topherCantrell/iot-DeskController/art/elevate.docx

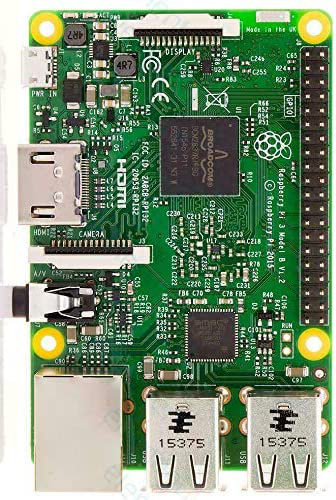
[picture p11: figure]
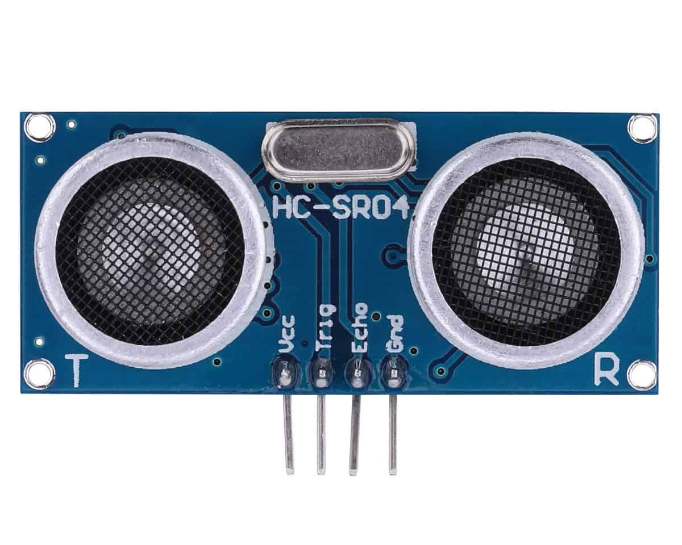
[picture p12: figure]
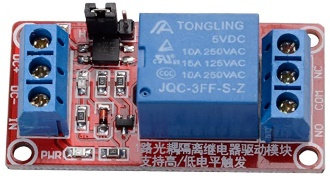
[picture p13: figure]

Common

Up

Down

COM

COM

NO

NO

5V

Gnd

Gnd

GP23

GP24

GP5

GP6

1K

2K
