topherCantrell/iot-DeskController/art/complete.jpg

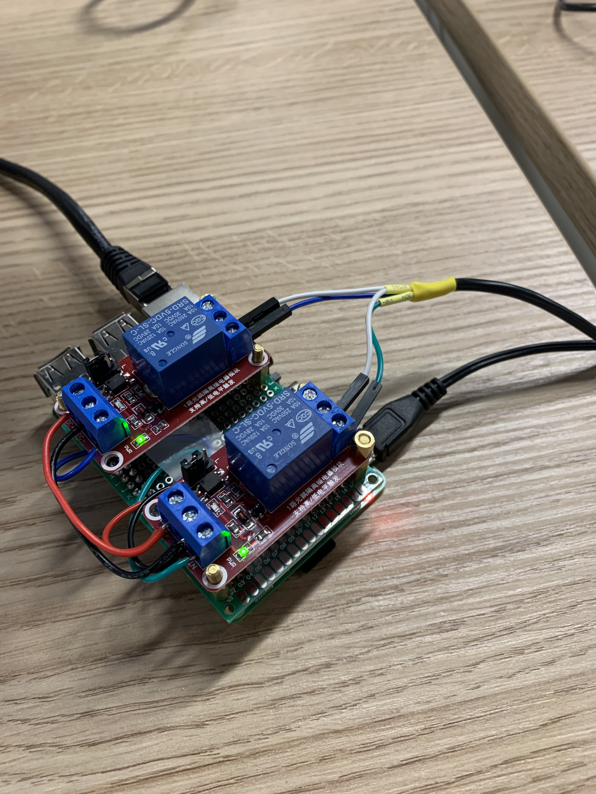
art/complete.jpg
