topherCantrell/iot-DeskController/art/desk01.jpg

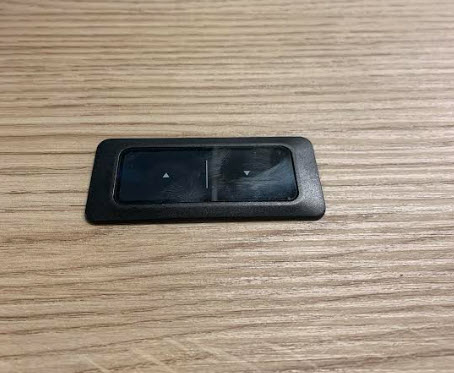
art/desk01.jpg
