topherCantrell/iot-DeskController/art/desk02.jpg

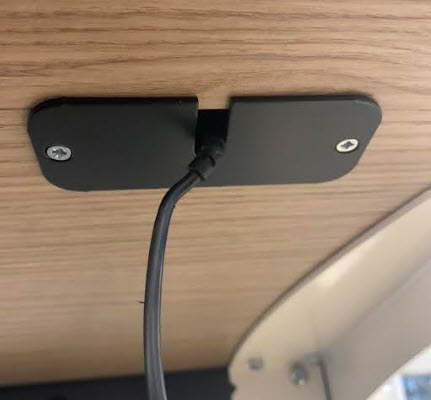
art/desk02.jpg
