topherCantrell/iot-DeskController/art/piboard.jpg

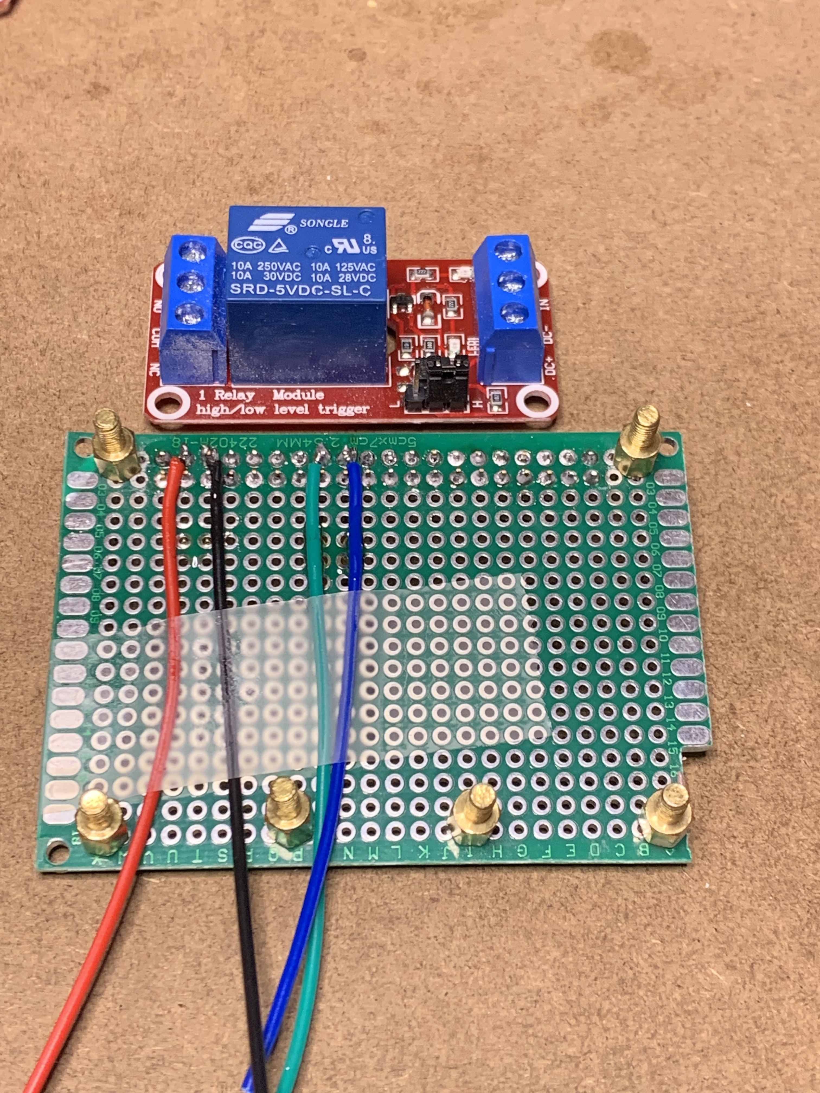
art/piboard.jpg
