topherCantrell/iot-DeskController/art/splice.jpg

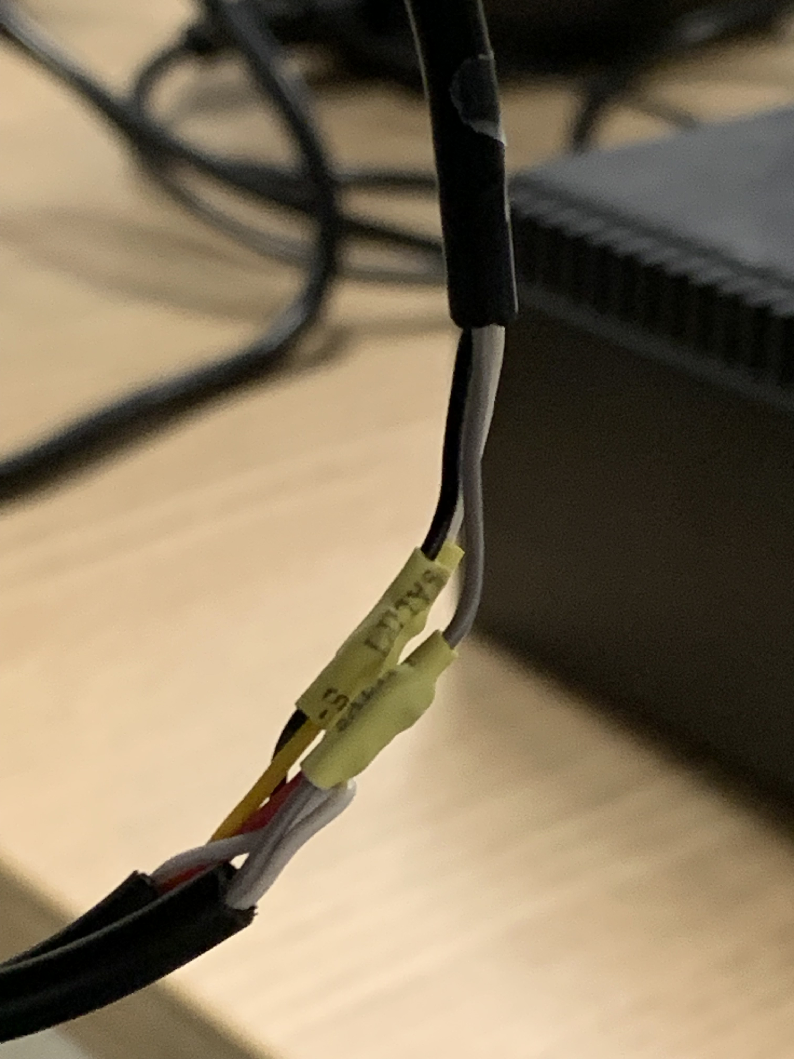
art/splice.jpg
