topherCantrell/iot-DeskController/art/switch.jpg

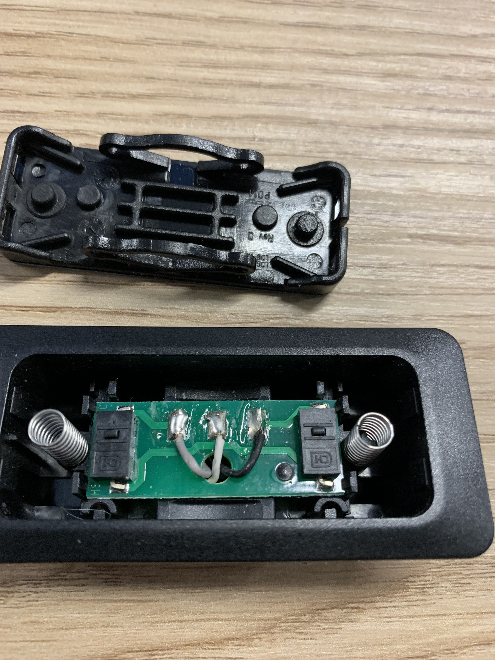
art/switch.jpg
