topherCantrell/iot-DeskController/art/parts01.jpg

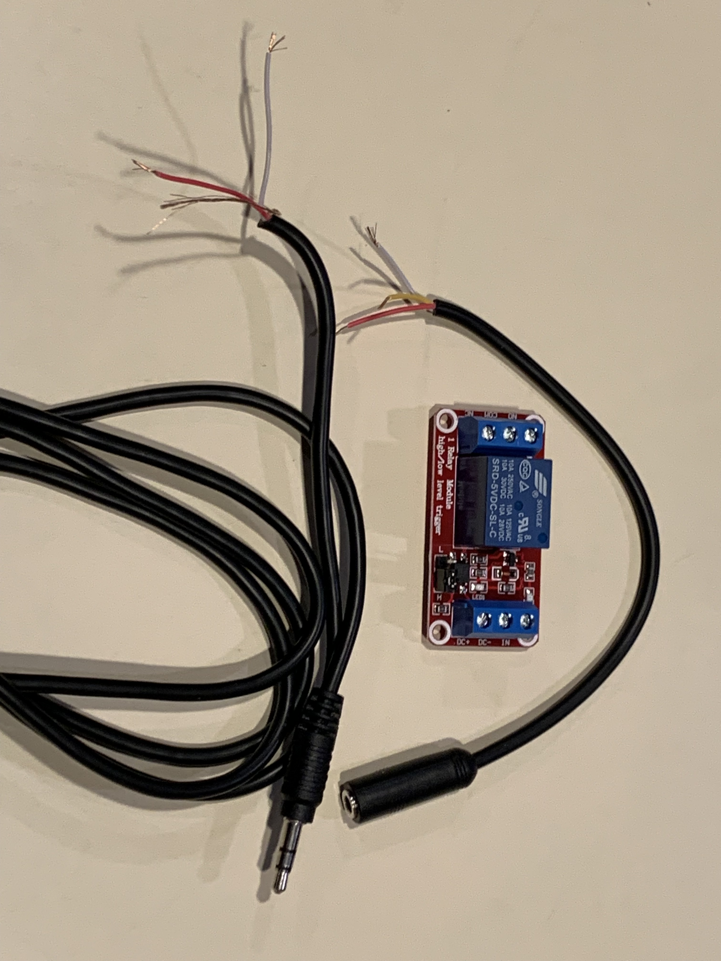
art/parts01.jpg
