topherCantrell/iot-DeskController/(list of files, drawings)

Other design files:
iotelevate.pcb
